tommassey/5v_to_bipolar15v_PSU/pcb0v3render.png

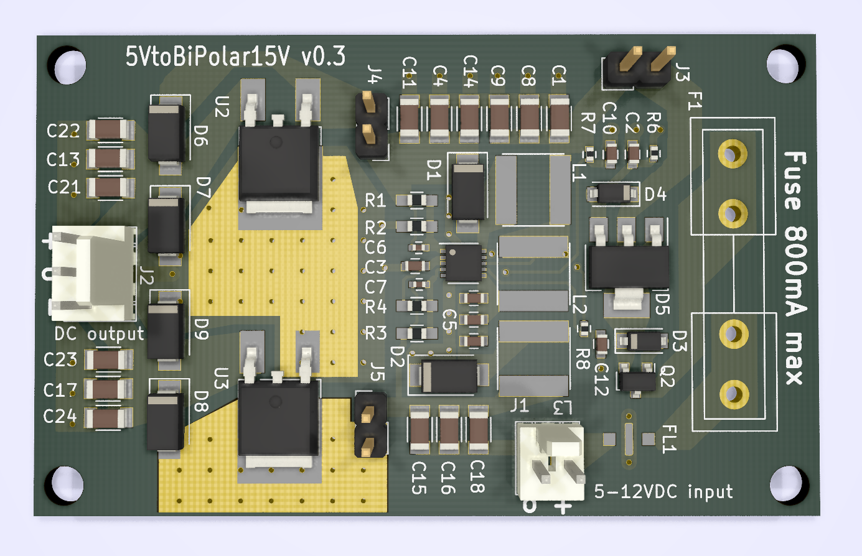
pcb0v3render.png
