tommassey/5v_to_bipolar15v_PSU/README.md

# 5v_to_bipolar15v_PSU

Kicad project for a small SMPS to provide ~200mA of +15v/-15v from a single 5v-12v DC supply
