tommassey/5v_to_bipolar15v_PSU/chargepumpschemo0v2.png

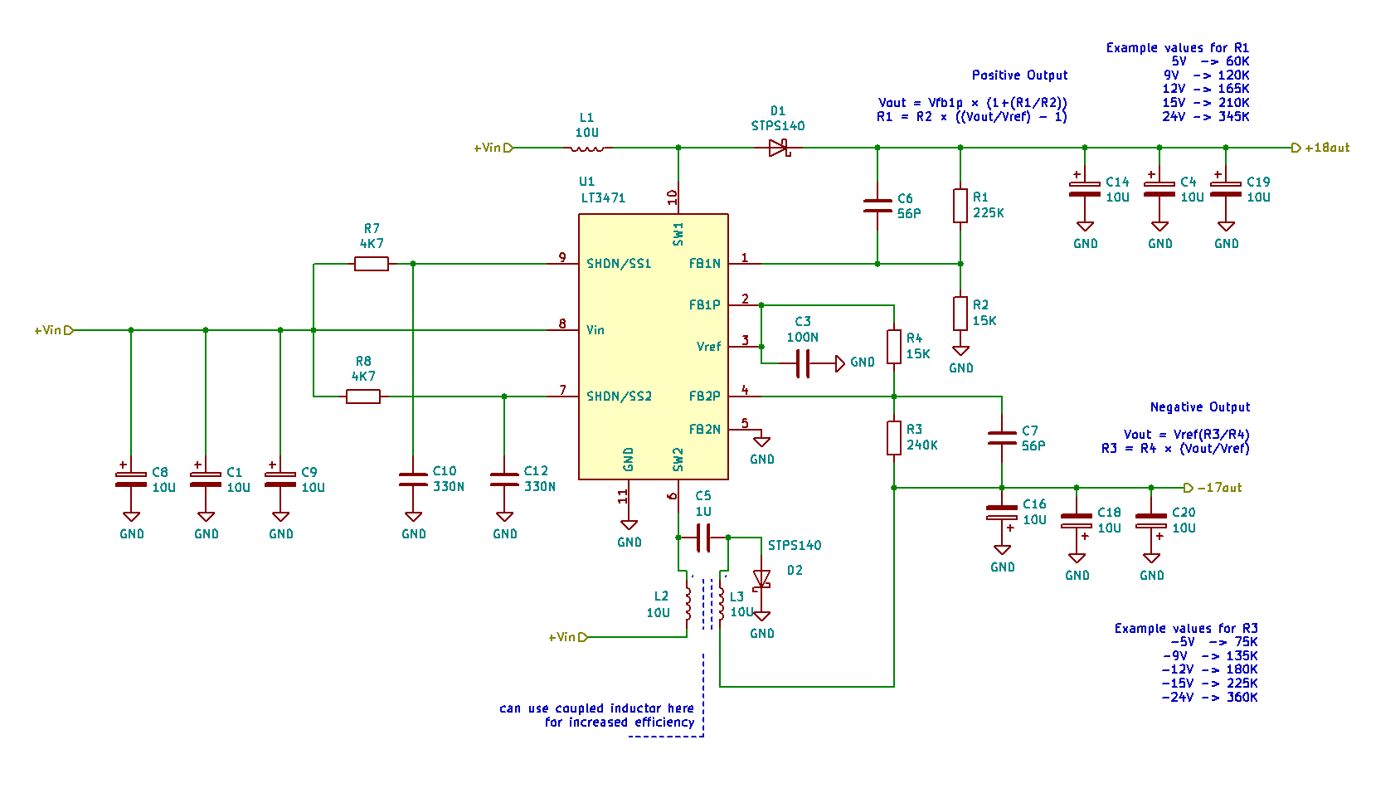
chargepumpschemo0v2.png
