tommassey/5v_to_bipolar15v_PSU/chargepumpschemo.png

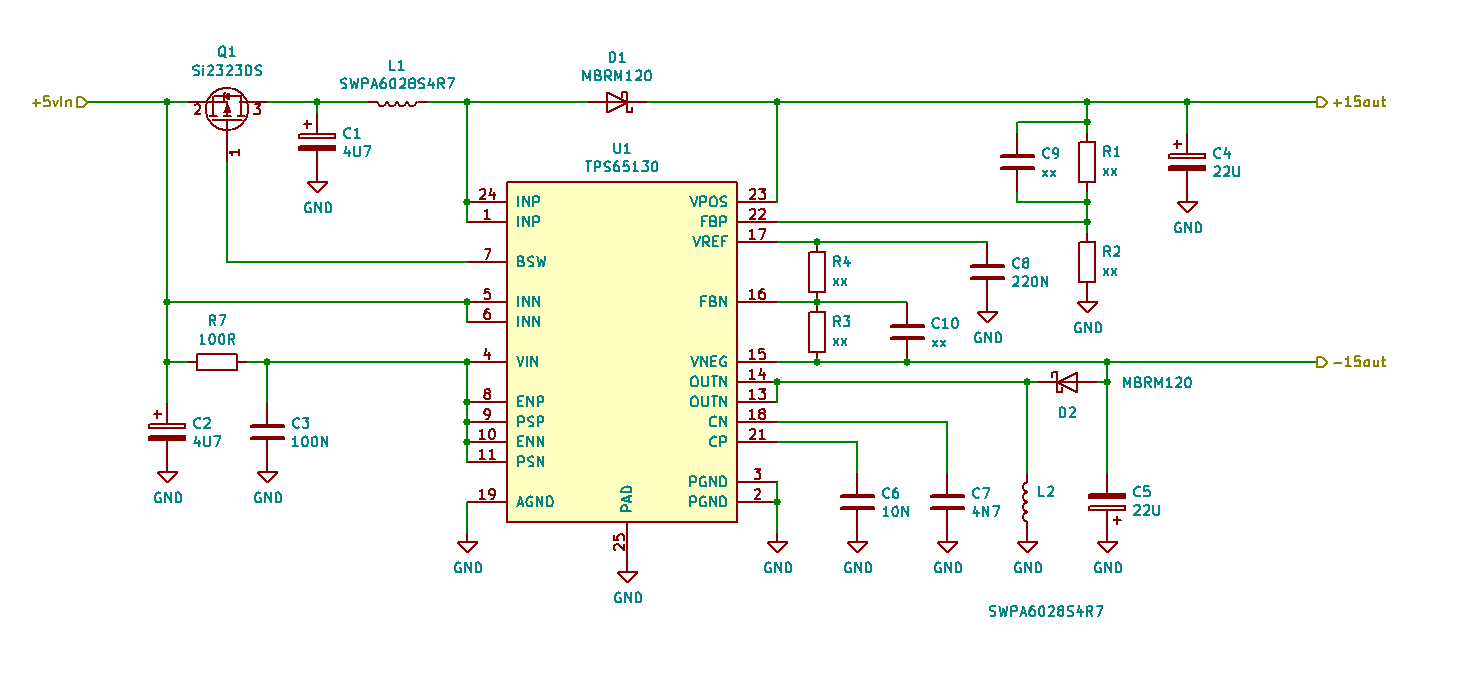
chargepumpschemo.png
