tommassey/5v_to_bipolar15v_PSU/mainschemo0v2.png

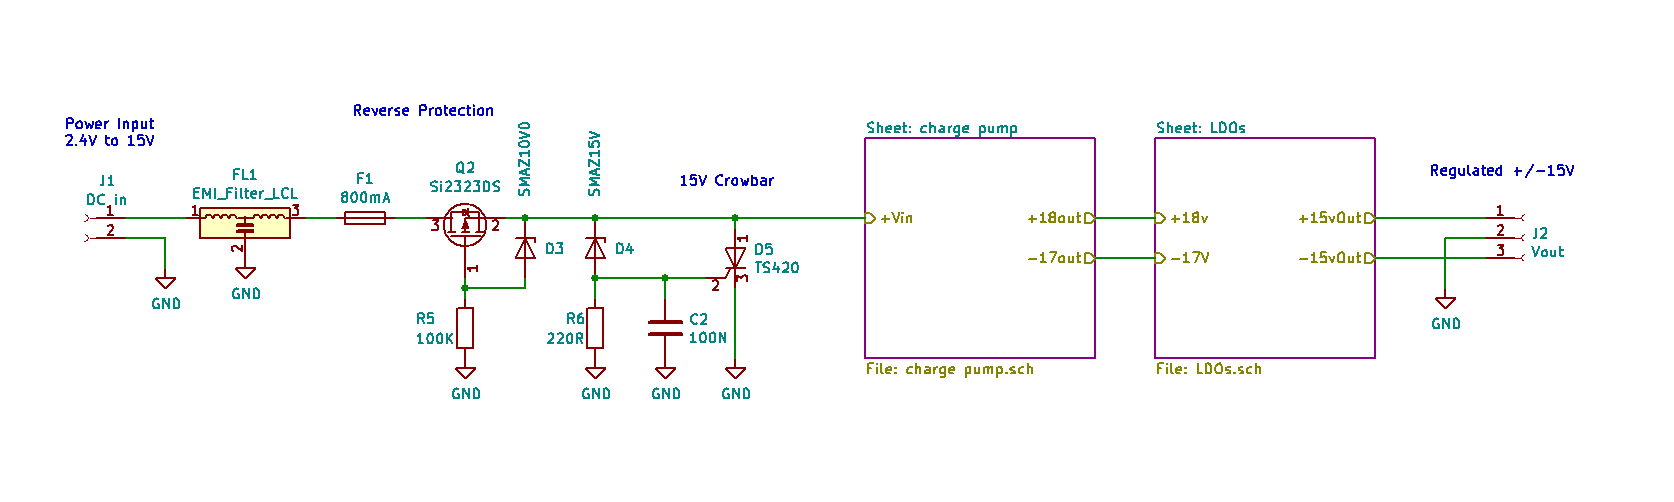
mainschemo0v2.png
