tommassey/5v_to_bipolar15v_PSU/mainschemo.png

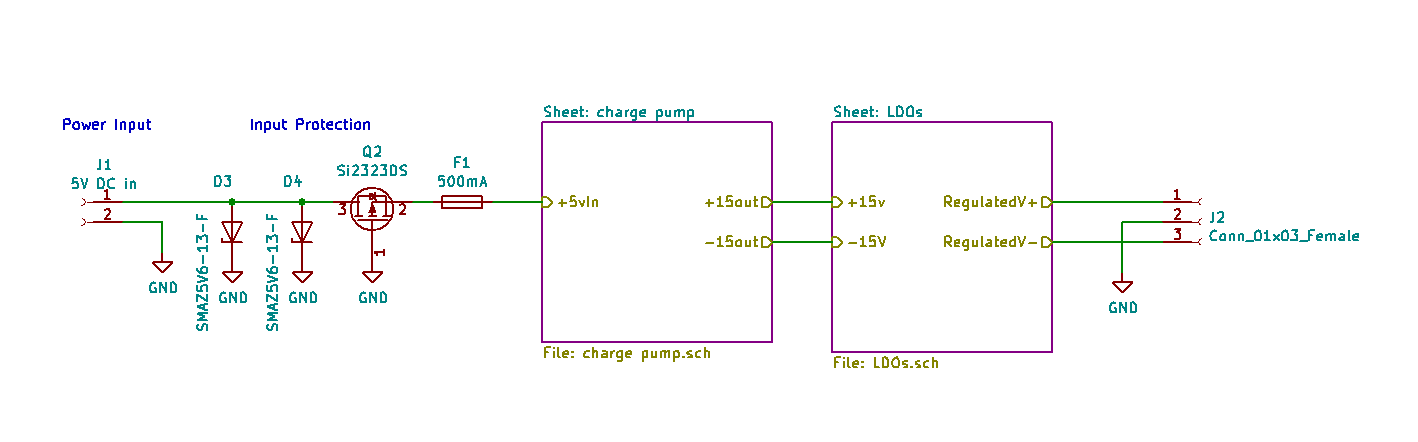
mainschemo.png
