tommassey/5v_to_bipolar15v_PSU/pcb0v2layers.png

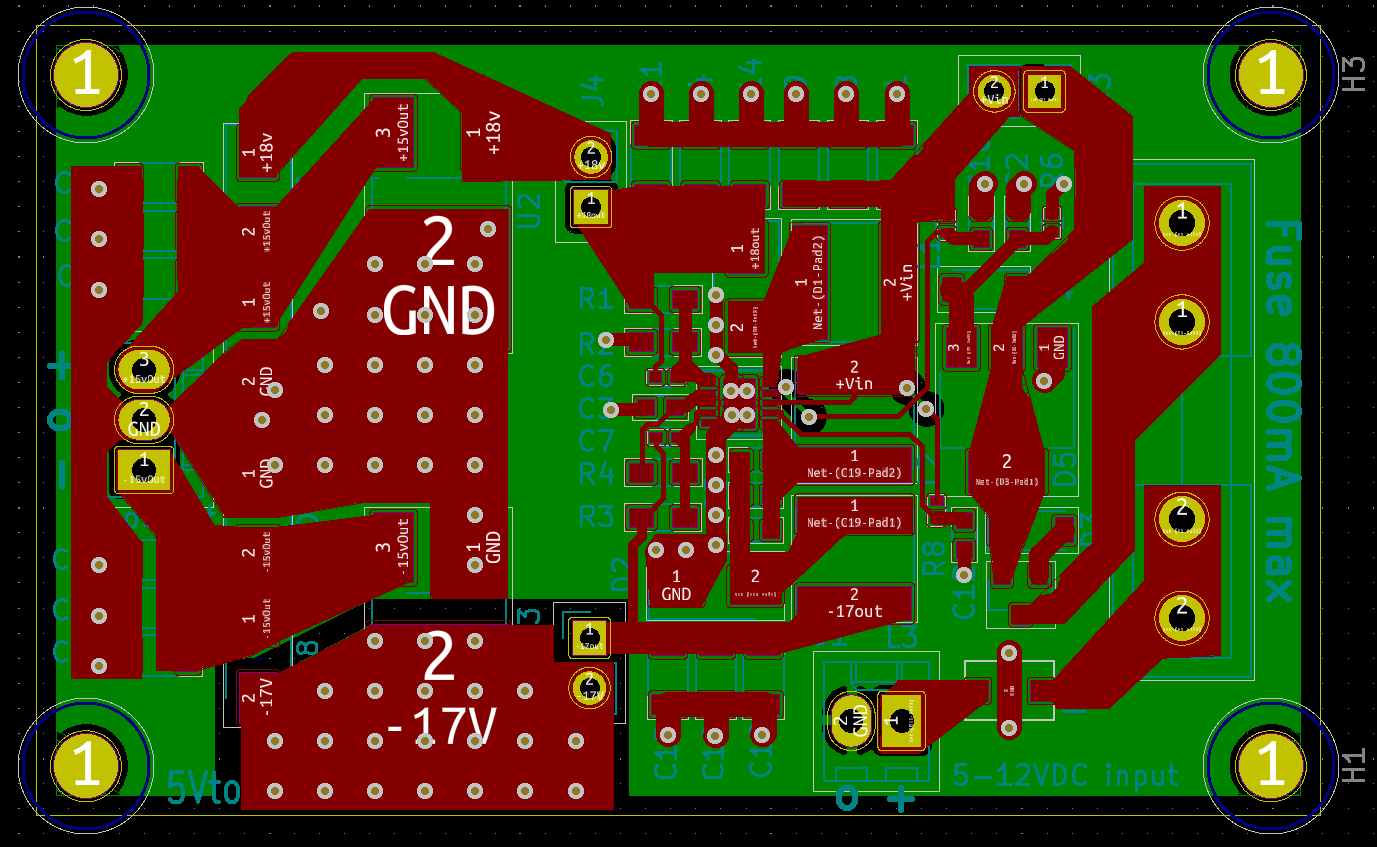
pcb0v2layers.png
