tommassey/5v_to_bipolar15v_PSU/pcb0v3renderrear.png

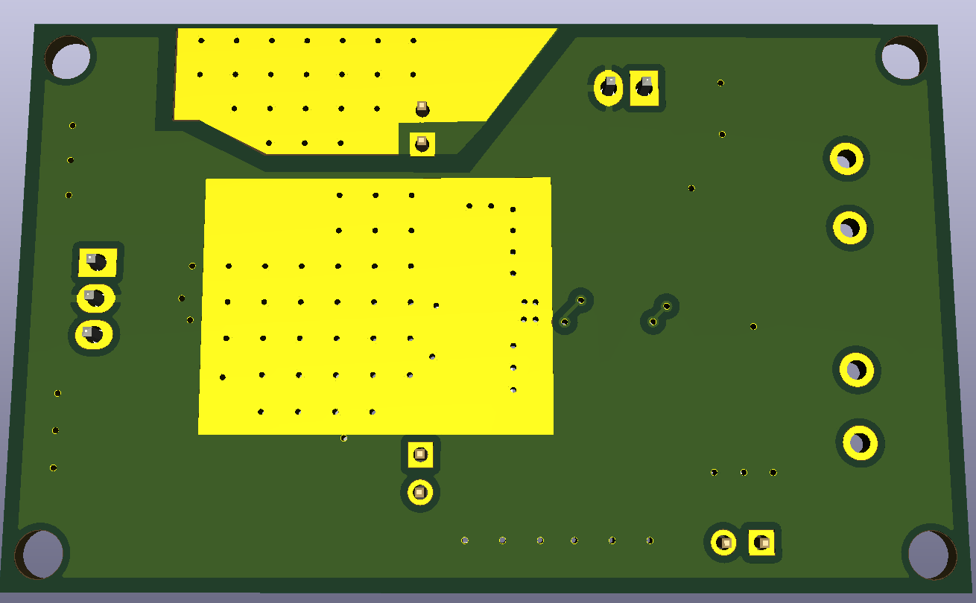
pcb0v3renderrear.png
