tommassey/5v_to_bipolar15v_PSU/pcb0v4render.png

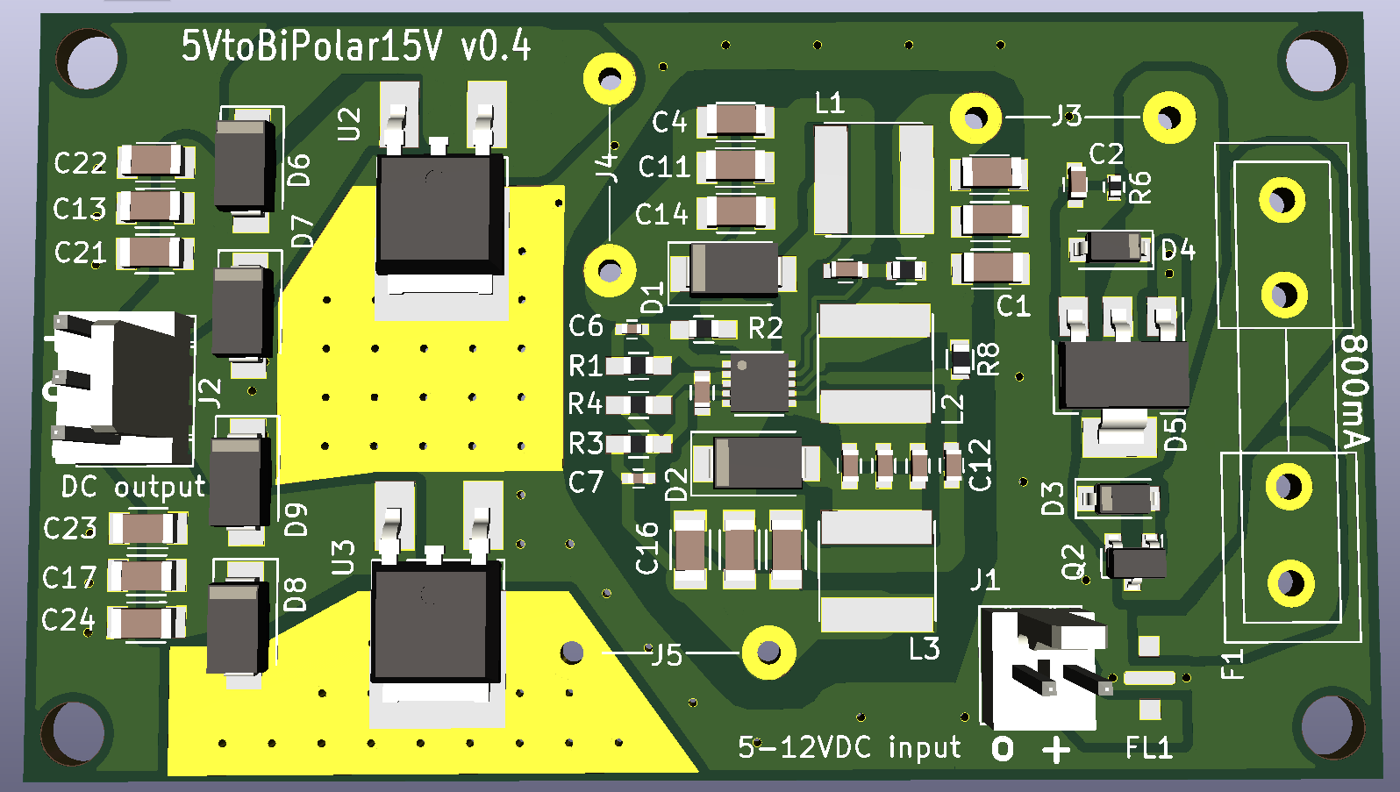
pcb0v4render.png
