tommassey/5v_to_bipolar15v_PSU/regulatorsschemo0v2.png

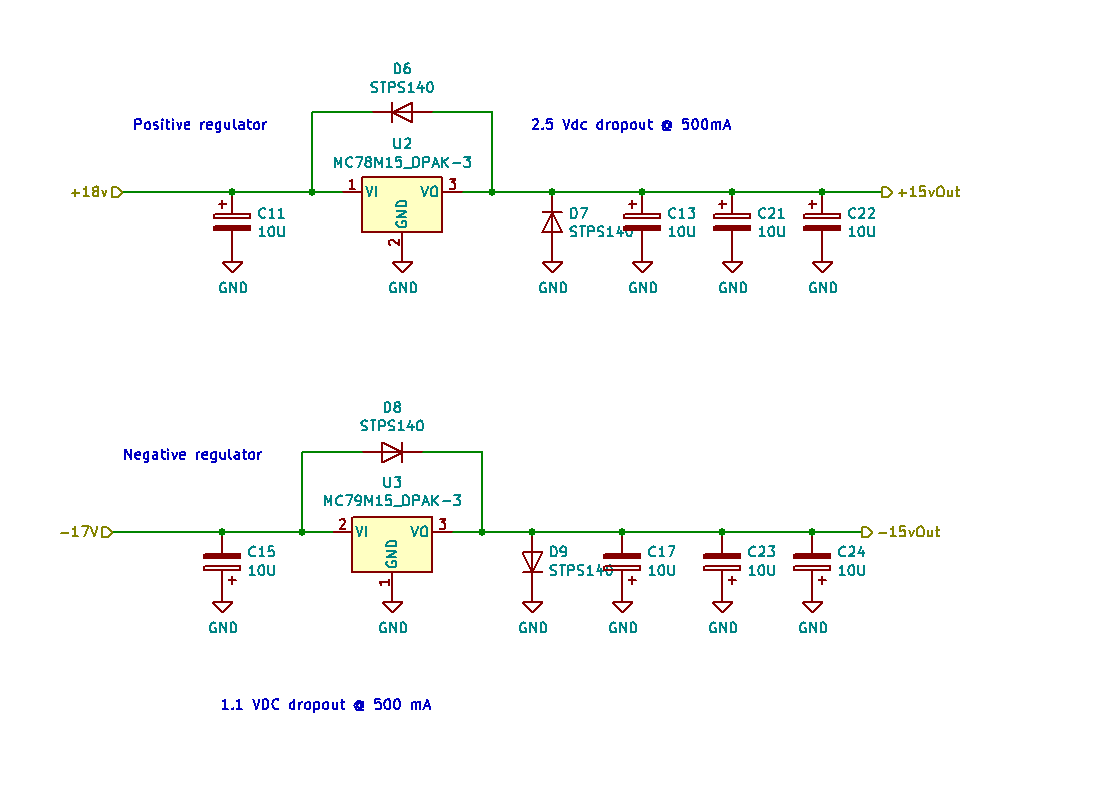
regulatorsschemo0v2.png
