tommassey/5v_to_bipolar15v_PSU/regulatorsschemo.png

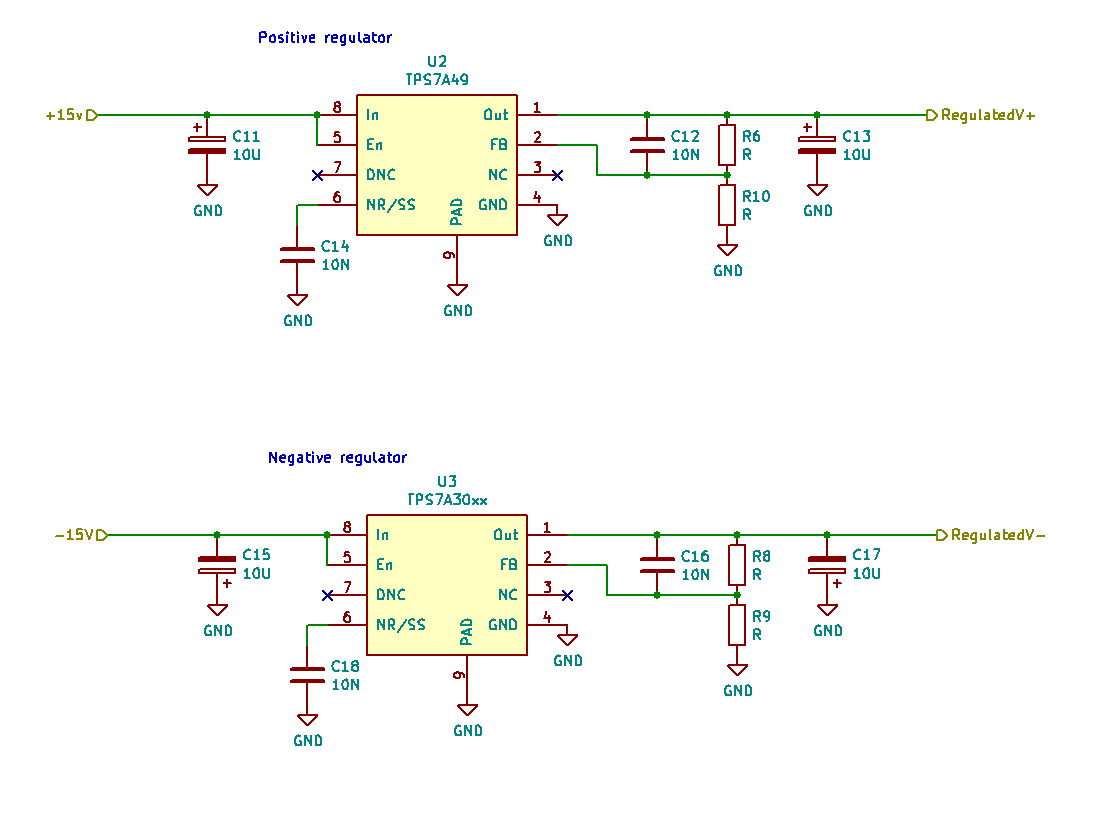
regulatorsschemo.png
