tommassey/5v_to_bipolar15v_PSU/5v_to_bipolar15v_PSU BOM.xls

Comment | Designator | Footprint
SMAZ15V | D4 | D_SOD-123
TP- | J5 | WireConnection_1.20mmDrill
TPin | J3 | WireConnection_1.20mmDrill
TP+ | J4 | WireConnection_1.20mmDrill
4K7 | R7,R8 | R_0603
100N | C3,C2 | C_0603
225K | R1 | R_0603_HandSoldering
15K | R2,R4 | R_0603_HandSoldering
330N | C12,C10,C20,C19,C5 | C_0603
DC in | J1 | Molex_KK-6410-02_02x2.54mm_Straight
EMI_Filter_LCL | L4 | Murata_EMIFIL_LC_NFE31PT
10U | C15,C11,C24,C23,C22,C21,C18,C17,C16,C14,C13,C9,C8,C4,C1 | C_1206
Z0109NN5AA4 | D5 | SOT-223-3_TabPin2
SMAZ10V0 | D3 | D_SOD-123
MC79M15_DPAK-3 | U3 | TO-252-2_Rectifier
MC78M15_DPAK-3 | U2 | TO-252-2_Rectifier
LT3471 | U1 | DFN-10-1EP_3x3mm_Pitch0.5mm
220R | R6 | R_0402
240K | R3 | R_0603_HandSoldering
Si2323DS | Q2 | SOT-23
10U | L3,L2,L1 | Sunlord_SWPA6028S
Vout | J2 | Molex_KK-6410-03_03x2.54mm_Straight
MountingHole | H4,H3,H2,H1 | MountingHole_3.2mm_M3
800mA | F1 | Fuseholder5x20_horiz_open_inline_Type-I
STPS140 | D9,D8,D7,D6,D2,D1 | D_SMA
56P | C7,C6 | C_0402
100K | R5 | R_0402
