tommassey/5v_to_bipolar15v_PSU/bom from JLCPCB.xls

Comment | Designator | Footprint | JLCPCB Part #
56P |  | C_0402 | C1572
225K |  | R_0603_HandSoldering | C22961
220R |  | R_0402 | C25091
10U |  | Sunlord_SWPA6028S | C79272
MC79M15_DPAK-3 |  | TO-252-2_Rectifier | C126298
Si2323DS |  | SOT-23 | C15127
330N |  | C_0603 | C1615
LT3471 |  | DFN-10-1EP_3x3mm_Pitch0.5mm | C107839
Z0109NN5AA4 |  | SOT-223-3_TabPin2 | C145131
STPS140 |  | D_SMA | C2480
EMI_Filter_LCL |  | Murata_EMIFIL_LC_NFE31PT | C86146
100N |  | C_0603 | C14663
SMAZ15V |  | D_SOD-123 | C173427
MC78M15_DPAK-3 |  | TO-252-2_Rectifier | C95992
4K7 |  | R_0603 | C23162
240K |  | R_0603_HandSoldering | C4197
15K |  | R_0603_HandSoldering | C22809
10U |  | C_1206 | C13585
SMAZ10V0 |  | D_SOD-123 | C173431
100K |  | R_0402 | C25741
