tommassey/5v_to_bipolar15v_PSU/5v_to_bipolar15v_PSU.kicad_pcb

## KiCad design 5v_to_bipolar15v_PSU.kicad_pcb (2023-04-29)

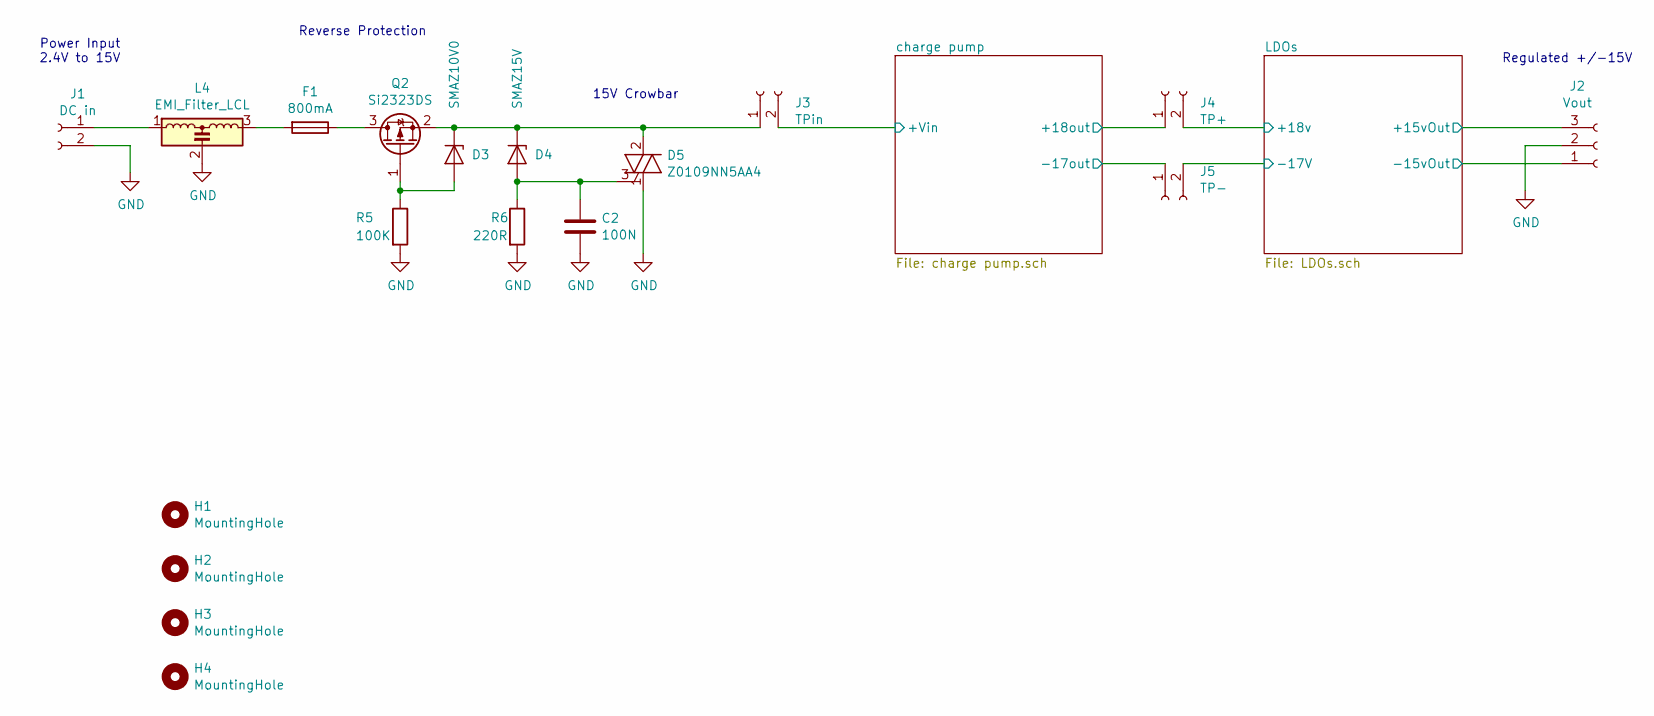
[picture p14: schematic 5v_to_bipolar15v_PSU.sch]

Parts:
C2: 100N; C_0402
D3: SMAZ10V0; D_SOD-123
D4: SMAZ15V; D_SOD-123
D5: Z0109NN5AA4; SOT-223-3_TabPin2
F1: 800mA; Fuseholder5x20_horiz_open_inline_Type-I
H1, H2, H3, H4: MountingHole; MountingHole_3.2mm_M3
J1: DC in; Molex_KK-6410-02_02x2.54mm_Straight
J2: Vout; Molex_KK-6410-03_03x2.54mm_Straight
J3: TPin; Pin_Header_Straight_1x02_Pitch2.54mm
J4: TP+; Pin_Header_Straight_1x02_Pitch2.54mm
J5: TP-; Pin_Header_Straight_1x02_Pitch2.54mm
L4: EMI_Filter_LCL; Murata_EMIFIL_LC_NFE31PT
Q2: Si2323DS; SOT-23
R5: 100K; R_0402
R6: 220R; R_0402

Connections:
/LDOs/+15vOut: J2.3; also elsewhere on the board
/LDOs/+18v: J4.2; also elsewhere on the board
/LDOs/-15vOut: J2.1; also elsewhere on the board
/LDOs/-17V: J5.2; also elsewhere on the board
/charge pump/+18out: J4.1; also elsewhere on the board
/charge pump/+Vin: J3.2; also elsewhere on the board
/charge pump/-17out: J5.1; also elsewhere on the board
GND: C2.2, D5.1 (A1), J1.2, J2.2, L4.2, R5.2, R6.2; also elsewhere on the board
unnamed: C2.1, D4.2 (A), D5.3 (G), R6.1
unnamed: D3.1 (K), D4.1 (K), D5.2 (A2), D5.4 (A4), J3.1, Q2.2 (S)
unnamed: D3.2 (A), Q2.1 (G), R5.1
unnamed: F1.1, Q2.3 (D)
unnamed: F1.2, L4.3
unnamed: J1.1, L4.1

Notes on the sheet:
Reverse Protection
Power Input 2.4V to 15V
15V Crowbar
Regulated +/-15V

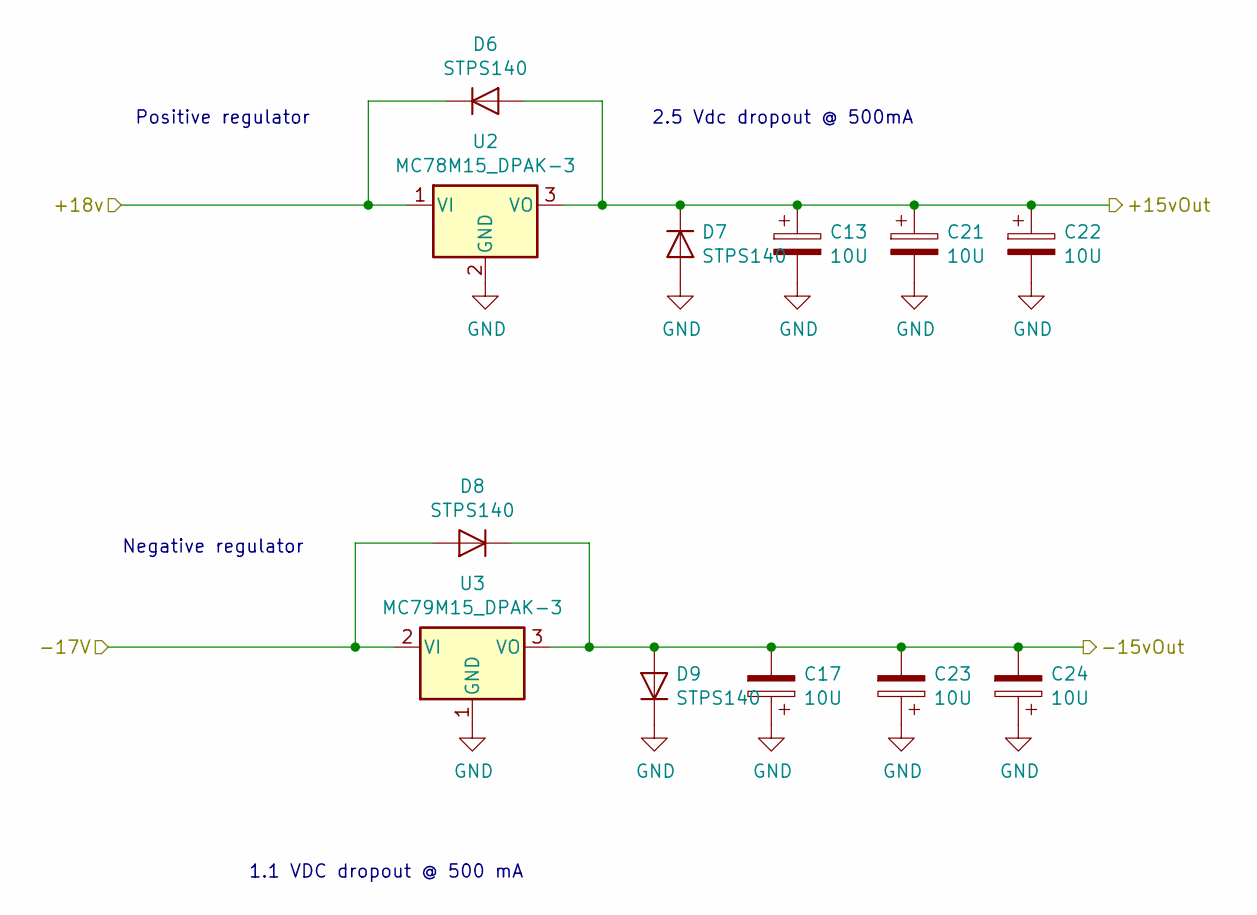
[picture p15: schematic LDOs.sch]

Parts:
C13, C17, C21, C22, C23, C24: 10U; C_1206
D6, D7, D8, D9: STPS140; D_SMA
U2: MC78M15_DPAK-3; TO-252-2_Rectifier
U3: MC79M15_DPAK-3; TO-252-2_Rectifier

Connections:
/LDOs/+15vOut: C13.1, C21.1, C22.1, D6.2 (A), D7.1 (K), U2.3 (VO); also elsewhere on the board
/LDOs/+18v: D6.1 (K), U2.1 (VI); also elsewhere on the board
/LDOs/-15vOut: C17.2, C23.2, C24.2, D8.1 (K), D9.2 (A), U3.3 (VO); also elsewhere on the board
/LDOs/-17V: D8.2 (A), U3.2 (VI); also elsewhere on the board
GND: C13.2, C17.1, C21.2, C22.2, C23.1, C24.1, D7.2 (A), D9.1 (K), U2.2 (GND), U3.1 (GND); also elsewhere on the board

Notes on the sheet:
Positive regulator
Negative regulator
1.1 VDC dropout @ 500 mA
2.5 Vdc dropout @ 500mA

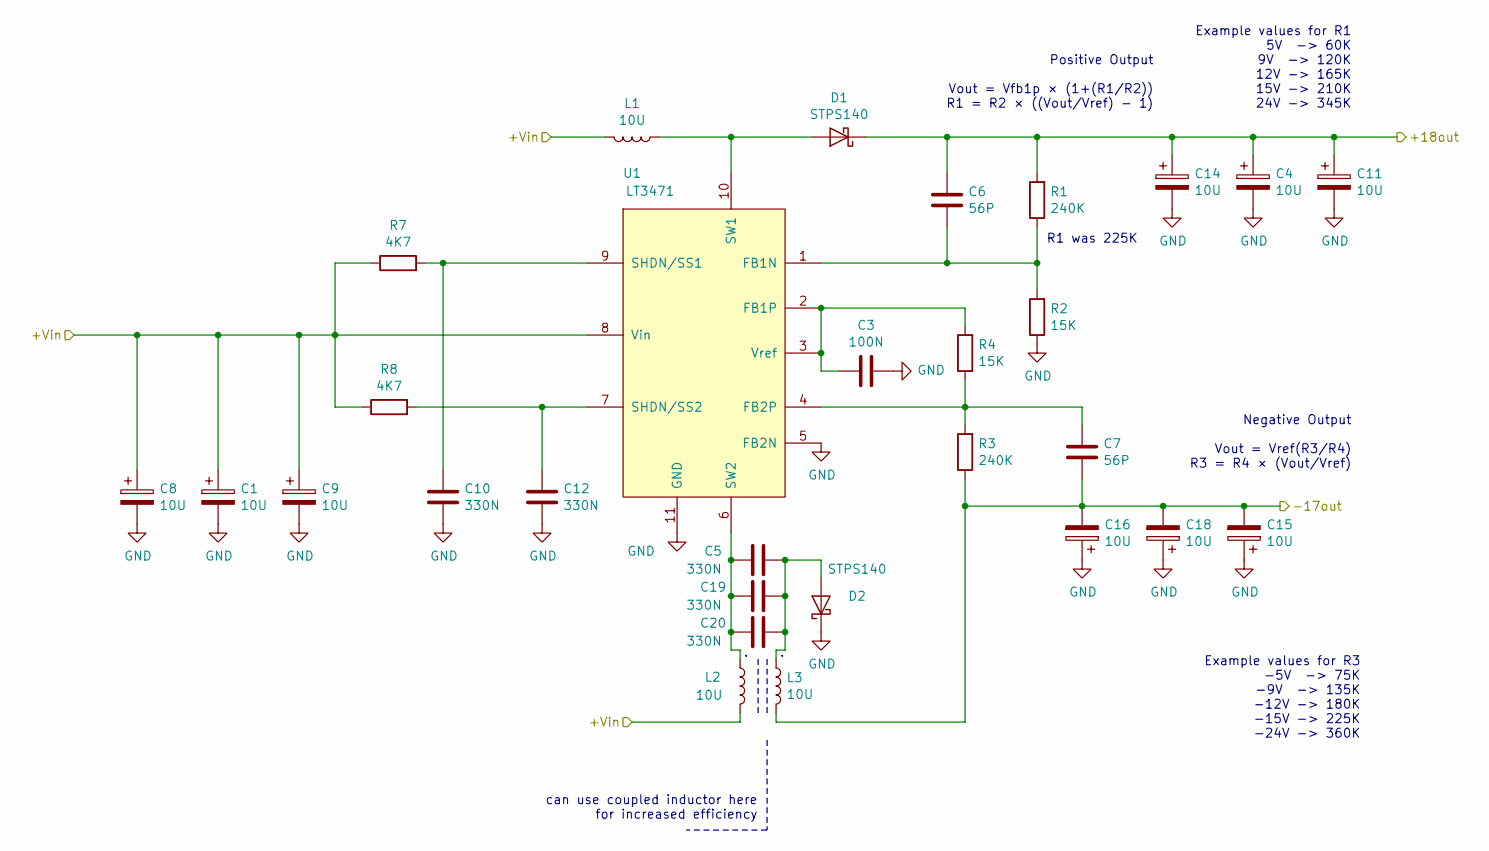
[picture p16: schematic charge pump.sch]

Parts:
C1, C4, C8, C9, C11, C14, C15, C16, C18: 10U; C_1206
C3: 100N; C_0402
C5, C10, C12, C19, C20: 330N; C_0603
C6, C7: 56P; C_0402
D1, D2: STPS140; D_SMA
L1, L2, L3: 10U; Sunlord_SWPA6028S
R1, R3: 240K; R_0603_HandSoldering
R2, R4: 15K; R_0603_HandSoldering
R7, R8: 4K7; R_0402
U1: LT3471; DFN-10-1EP_3x3mm_Pitch0.5mm

Connections:
/charge pump/+18out: C4.1, C6.1, C11.1, C14.1, D1.1 (K), R1.2; also elsewhere on the board
/charge pump/+Vin: C1.1, C8.1, C9.1, L1.2, L2.2, R7.1, R8.1, U1.8 (Vin); also elsewhere on the board
/charge pump/-17out: C7.2, C15.2, C16.2, C18.2, L3.2, R3.1; also elsewhere on the board
GND: C1.2, C3.1, C4.2, C8.2, C9.2, C10.1, C11.2, C12.1, C14.2, C15.1, C16.1, C18.1, D2.1 (K), R2.1, U1.5 (FB2N), U1.11 (GND); also elsewhere on the board
unnamed: C3.2, R4.2, U1.2 (FB1P), U1.3 (Vref)
unnamed: C6.2, R1.1, R2.2, U1.1 (FB1N)
unnamed: C7.1, R3.2, R4.1, U1.4 (FB2P)
unnamed: C10.2, R7.2, U1.9 (SHDN/SS1)
unnamed: C12.2, R8.2, U1.7 (SHDN/SS2)
unnamed: C5.1, C19.1, C20.1, D2.2 (A), L3.1
unnamed: C5.2, C19.2, C20.2, L2.1, U1.6 (SW2)
unnamed: D1.2 (A), L1.1, U1.10 (SW1)

Notes on the sheet:
Positive Output Vout = Vfb1p × (1+(R1/R2)) R1 = R2 × ((Vout/Vref) - 1)
Negative Output Vout = Vref(R3/R4) R3 = R4 × (Vout/Vref)
Example values for R3 -5V -> 75K -9V -> 135K -12V -> 180K -15V -> 225K -24V -> 360K
Example values for R1 5V -> 60K 9V -> 120K 12V -> 165K 15V -> 210K 24V -> 345K
can use coupled inductor here for increased efficiency
R1 was 225K

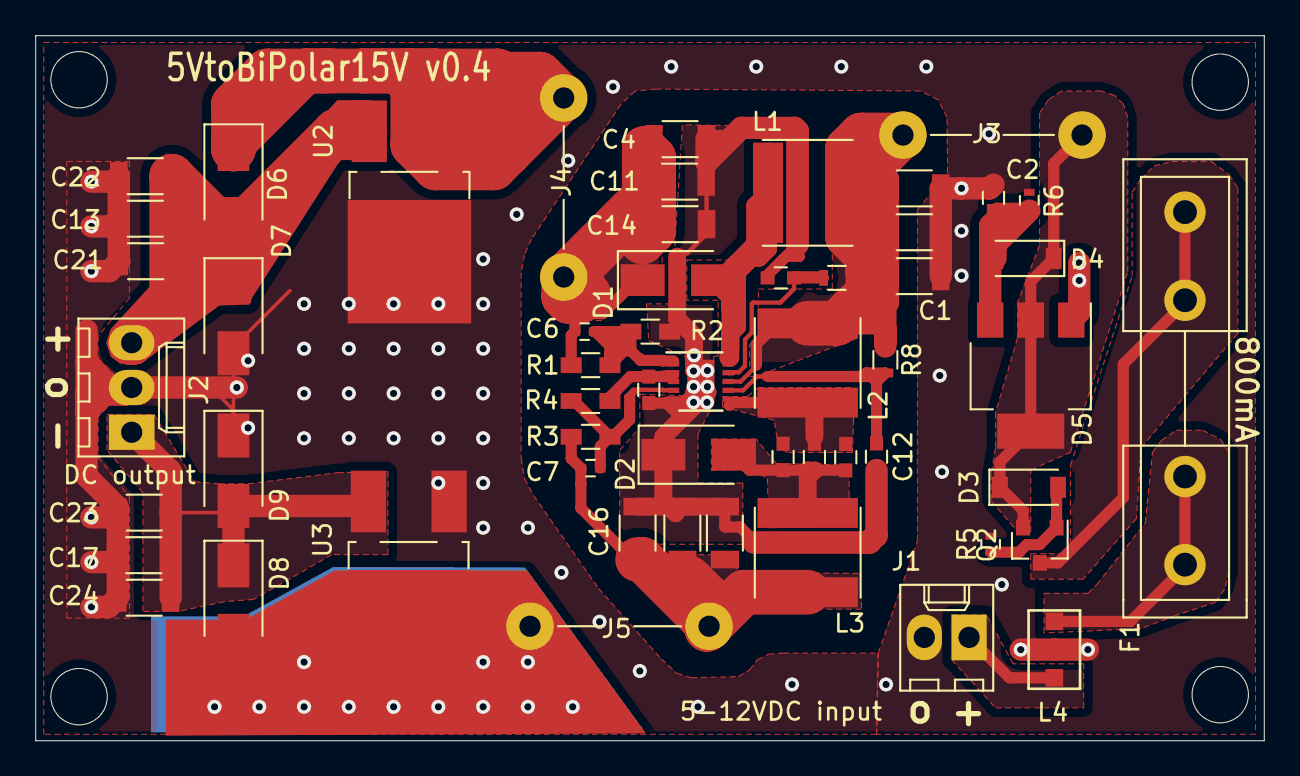
[picture p17: board 5v_to_bipolar15v_PSU.kicad_pcb from above]

Board: 2 copper layers, 69.7 x 40.0 mm, 59 parts (0 on the bottom side), 22 nets.
